acusticaescolar-star/registrador-ambiental/README.md

# registrador-ambiental
Registrador ambiental para el aula: CO2, temperatura, humedad y ruido. Proyecto abierto de acusticaescolar.com
